MelyGalvez/Volting-MUSIC-Project/README.md

# Volting Music Project

Extension of Volting Music Project to a more immersive environnement in Tongji University.
