MelyGalvez/Volting-MUSIC-Project/Suit_Developement/Hardware/PCB/Central_Unit/V1/Images/PCB_Images/Central_Unit_PCB.pdf

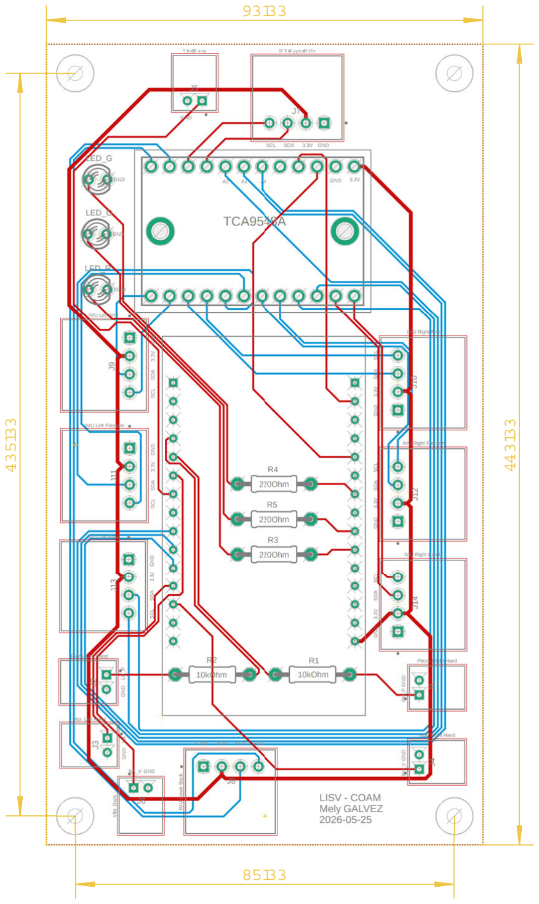
[picture p1: figure]
Vibr. Front; IMU U pper Back
