MelyGalvez/Volting-MUSIC-Project/Suit_Developement/Hardware/PCB/Central_Unit/V2/Images/PCB_Images/Central_Unit_V2_Bottom.png

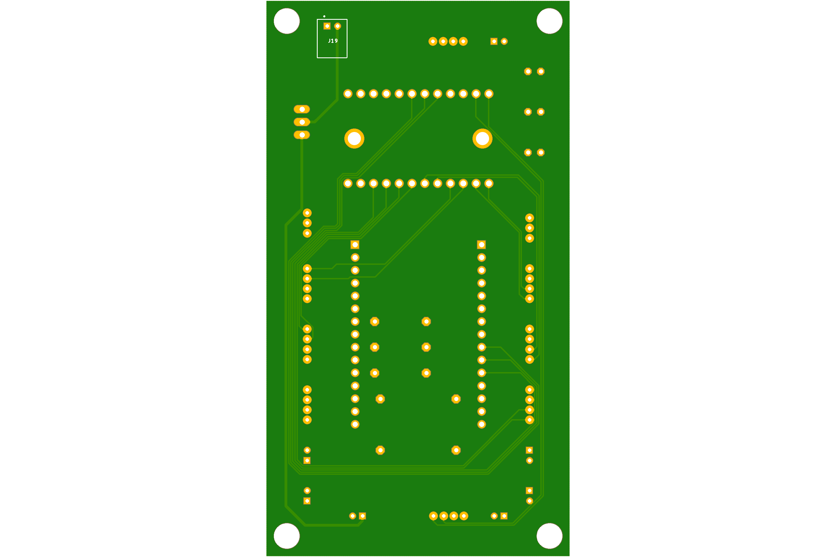
Suit_Developement/Hardware/PCB/Central_Unit/V2/Images/PCB_Images/Central_Unit_V2_Bottom.png
