MelyGalvez/Volting-MUSIC-Project/Suit_Developement/Hardware/PCB/IMU/Images/PCB_Images/IMU_PCB_Bottom.png

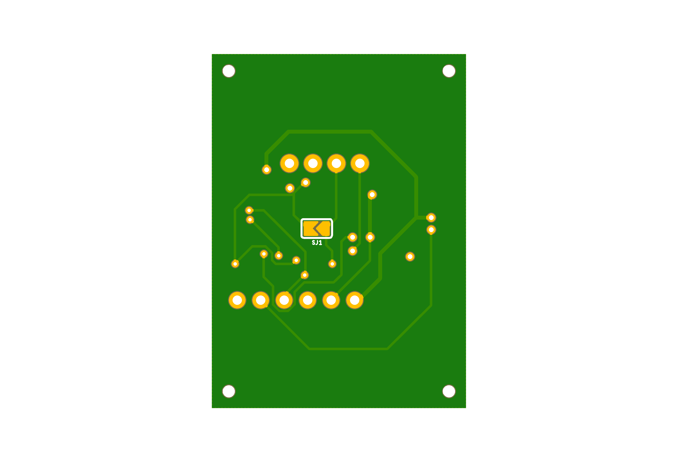
Suit_Developement/Hardware/PCB/IMU/Images/PCB_Images/IMU_PCB_Bottom.png
