MelyGalvez/Volting-MUSIC-Project/Suit_Developement/Hardware/PCB/IMU/Images/PCB_Images/IMU_PCB_Drills.png

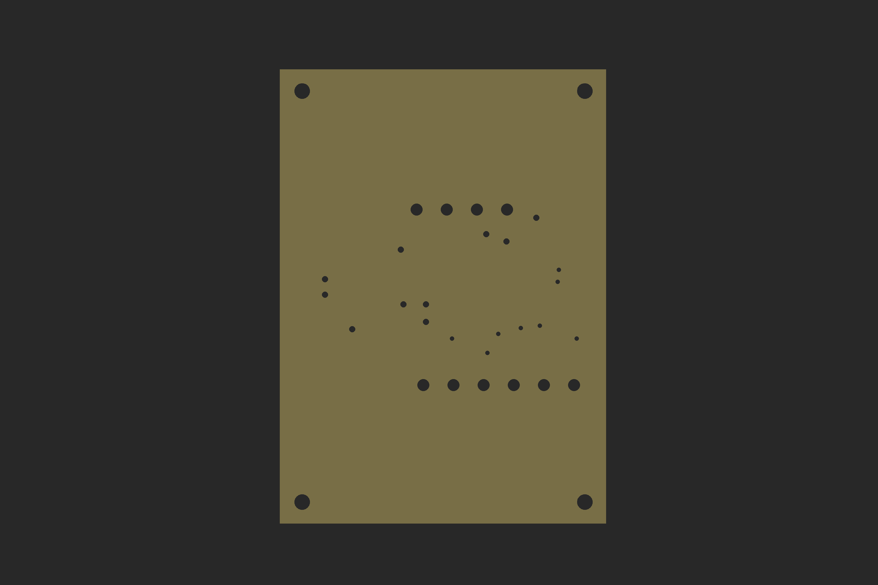
Suit_Developement/Hardware/PCB/IMU/Images/PCB_Images/IMU_PCB_Drills.png
