MelyGalvez/Volting-MUSIC-Project/Suit_Developement/Hardware/PCB/IMU_Breakout/Images/PCB_Images/IMU_PCB_Breakout_Bottom.png

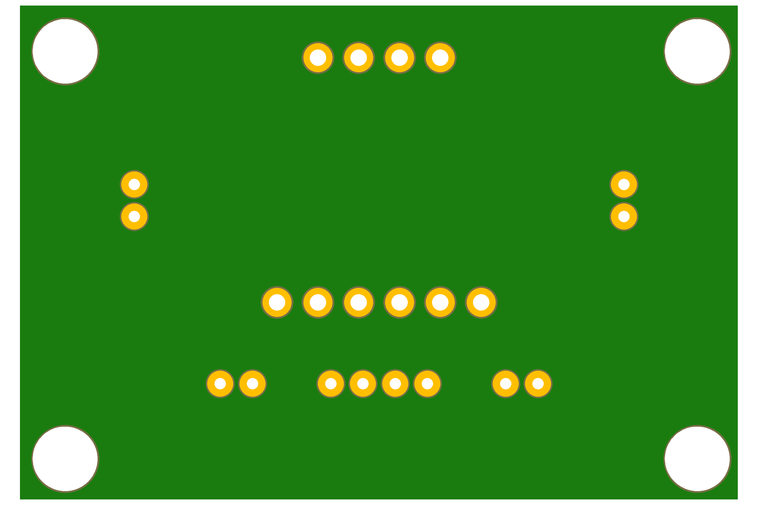
Suit_Developement/Hardware/PCB/IMU_Breakout/Images/PCB_Images/IMU_PCB_Breakout_Bottom.png
