MelyGalvez/Volting-MUSIC-Project/Suit_Developement/Software/Perceptual_Space/Interfaces/Visual/Images/Motion_Capture_3D.PNG

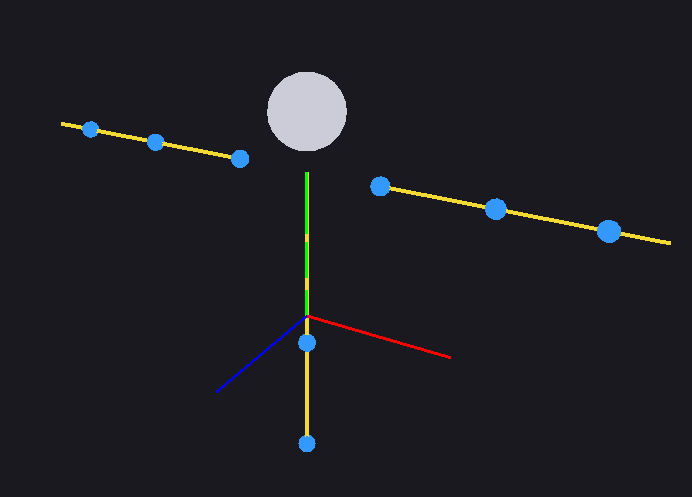
Suit_Developement/Software/Perceptual_Space/Interfaces/Visual/Images/Motion_Capture_3D.PNG
