MelyGalvez/Volting-MUSIC-Project/Suit_Developement/Software/Perceptual_Space/Interfaces/Visual/Images/Touch_Designer.PNG

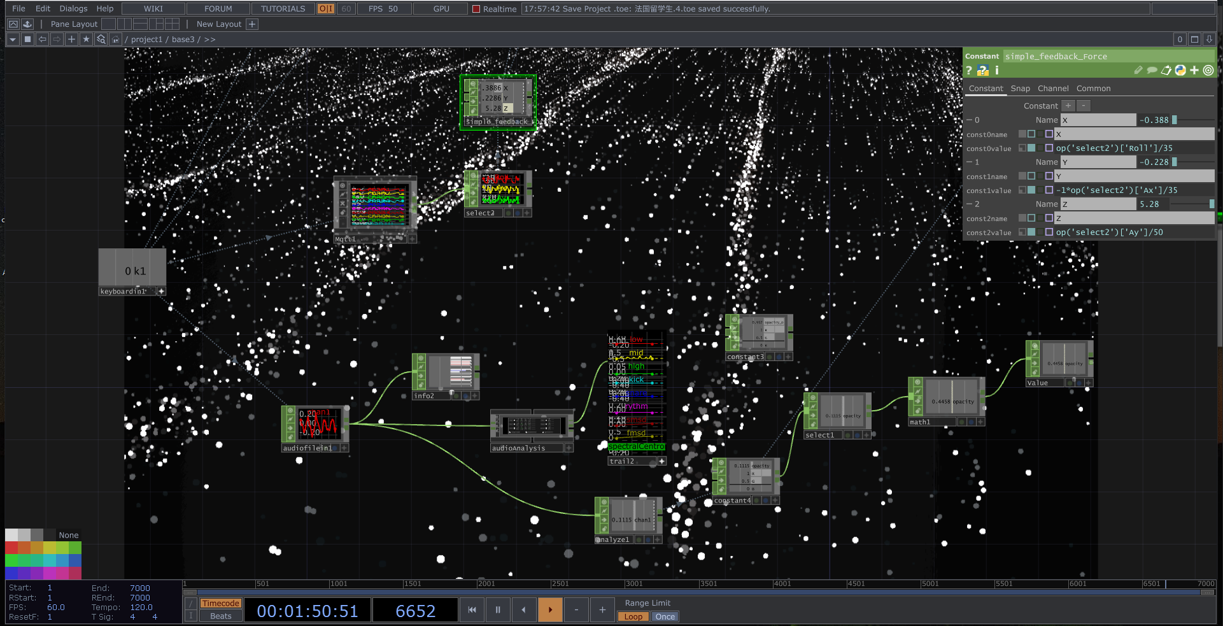
Suit_Developement/Software/Perceptual_Space/Interfaces/Visual/Images/Touch_Designer.PNG
