MelyGalvez/Volting-MUSIC-Project/Suit_Developement/Hardware/Case/Central_Unit_Case/Central_Unit_Case_V2.3mf

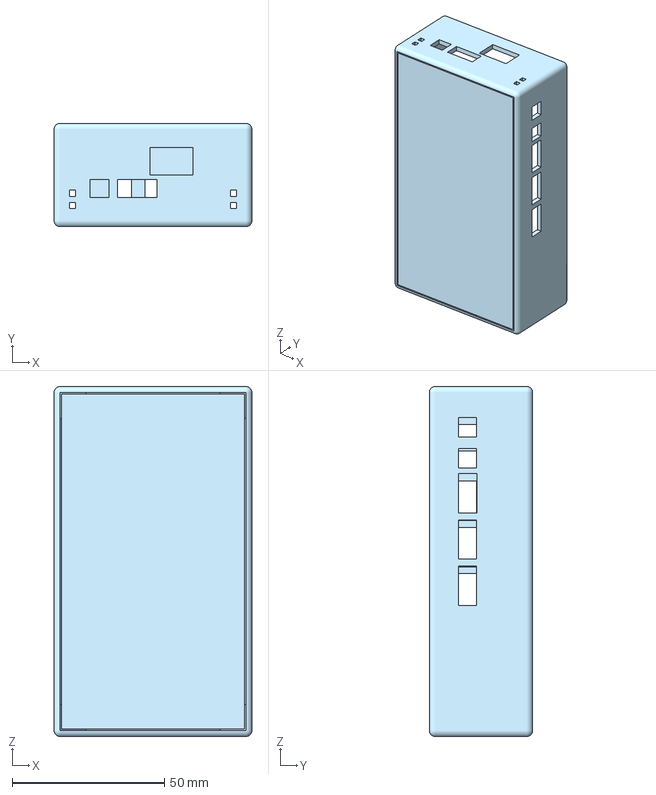
[picture p12: CAD file, 2026-07-07]
Suit_Developement/Hardware/Case/Central_Unit_Case/Central_Unit_Case_V2.3mf
65.0 x 34.0 x 115.0 mm
