MelyGalvez/Volting-MUSIC-Project/Suit_Developement/Hardware/Case/IMU_Breakout_Case/IMU_Breakout_Case.stl

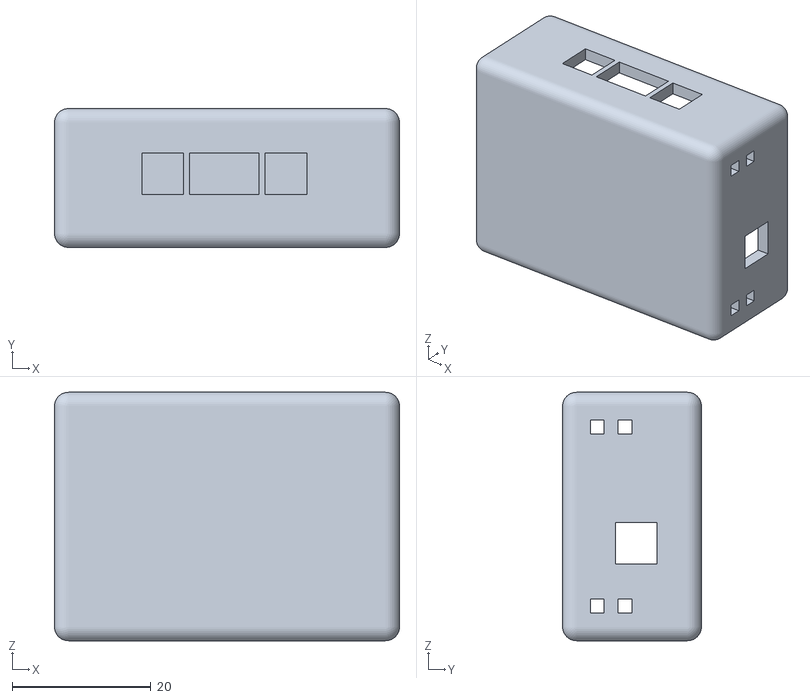
[picture p13: CAD file, 2026-05-29]
Suit_Developement/Hardware/Case/IMU_Breakout_Case/IMU_Breakout_Case.stl
49.7 x 20.0 x 35.8
