MelyGalvez/Volting-MUSIC-Project/Immersive_Env_Test/Measurememt codes/Volting_MUSIC_All_Data_Measurement/Measuremets results/Position_Measurement_20260420_160034.csv

time | ACC_x | ACC_y | ACC_z | GYRO_x | GYRO_y | GYRO_z | MAG_x | MAG_y | MAG_z | D1 | D2 | BTN1 | BTN2
1776672035.715073 | 12 | 10 | 253 | -791 | 31 | -13 | 162 | -126 | -431 | 3 | 0 | 0 | 0
1776672035.8428078 | 13 | 10 | 253 | -778 | 52 | -3 | 163 | -128 | -432 | 3 | 0 | 0 | 0
1776672035.9693692 | 12 | 12 | 254 | -753 | 35 | -5 | 165 | -128 | -432 | 3 | 0 | 0 | 0
1776672036.0951345 | 13 | 11 | 253 | -800 | 49 | -11 | 164 | -127 | -432 | 3 | 0 | 0 | 0
1776672036.222291 | 12 | 11 | 253 | -793 | 19 | -24 | 164 | -128 | -432 | 3 | 0 | 0 | 0
1776672036.34781 | 13 | 10 | 254 | -784 | 3 | -24 | 164 | -128 | -432 | 3 | 0 | 0 | 0
1776672036.4747362 | 12 | 12 | 253 | -779 | 53 | -22 | 164 | -128 | -433 | 3 | 0 | 0 | 0
1776672036.6024406 | 13 | 10 | 252 | -782 | 43 | -7 | 164 | -128 | -433 | 3 | 0 | 0 | 0
1776672036.7273338 | 13 | 10 | 254 | -790 | 36 | -7 | 163 | -127 | -432 | 3 | 0 | 0 | 0
1776672036.8556764 | 12 | 12 | 253 | -792 | 26 | -33 | 163 | -129 | -430 | 3 | 0 | 0 | 0
1776672036.9809878 | 12 | 11 | 255 | -807 | 33 | -15 | 164 | -128 | -432 | 3 | 0 | 0 | 0
1776672037.1074395 | 13 | 10 | 253 | -793 | 38 | -2 | 164 | -128 | -432 | 3 | 0 | 0 | 0
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
