MelyGalvez/Volting-MUSIC-Project/Immersive_Env_Test/Measurememt codes/Volting_MUSIC_All_Data_Measurement/Measuremets results/Position_Measurement_20260420_164400.csv

time | ACC_x | ACC_y | ACC_z | GYRO_x | GYRO_y | GYRO_z | MAG_x | MAG_y | MAG_z | D1 | D2 | BTN1 | BTN2
1776674642.1041398 | -7 | 259 | -3 | -588 | -650 | 524 | -425 | -378 | -42 | 3 | 0 | 0 | 0
1776674642.231054 | -4 | 265 | -10 | -1187 | -1287 | 904 | -424 | -375 | -31 | 5 | 0 | 0 | 0
1776674642.3591402 | -2 | 262 | -5 | -226 | -448 | 157 | -426 | -373 | -22 | 6 | 0 | 0 | 0
1776674642.4864442 | -12 | 257 | -6 | 631 | -1206 | -889 | -421 | -371 | -6 | 10 | 0 | 0 | 0
1776674642.6425881 | -14 | 274 | -17 | -755 | 492 | 53 | -412 | -374 | 7 | 0 | 0 | 0 | 0
1776674642.7886276 | -14 | 268 | -22 | -205 | -1375 | 486 | -411 | -371 | 19 | 0 | 0 | 0 | 0
1776674642.9445589 | -14 | 269 | -14 | -2376 | -3247 | -1757 | -402 | -368 | 40 | 0 | 0 | 0 | 0
1776674643.0921638 | -19 | 256 | -21 | -1032 | -5416 | -377 | -377 | -378 | 63 | 0 | 0 | 0 | 0
1776674643.2195287 | -17 | 261 | -7 | -2073 | 2171 | -1840 | -355 | -374 | 98 | 11 | 0 | 0 | 0
1776674643.3466606 | -13 | 254 | -6 | -1380 | -2435 | -1942 | -340 | -382 | 103 | 3 | 0 | 0 | 0
1776674643.4735425 | -10 | 256 | -12 | 486 | -2093 | -356 | -312 | -395 | 115 | 2 | 0 | 0 | 0
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
