MelyGalvez/Volting-MUSIC-Project/Initial_Prototype/V1/PCB/Measurement_Device_PCB/silk.pdf

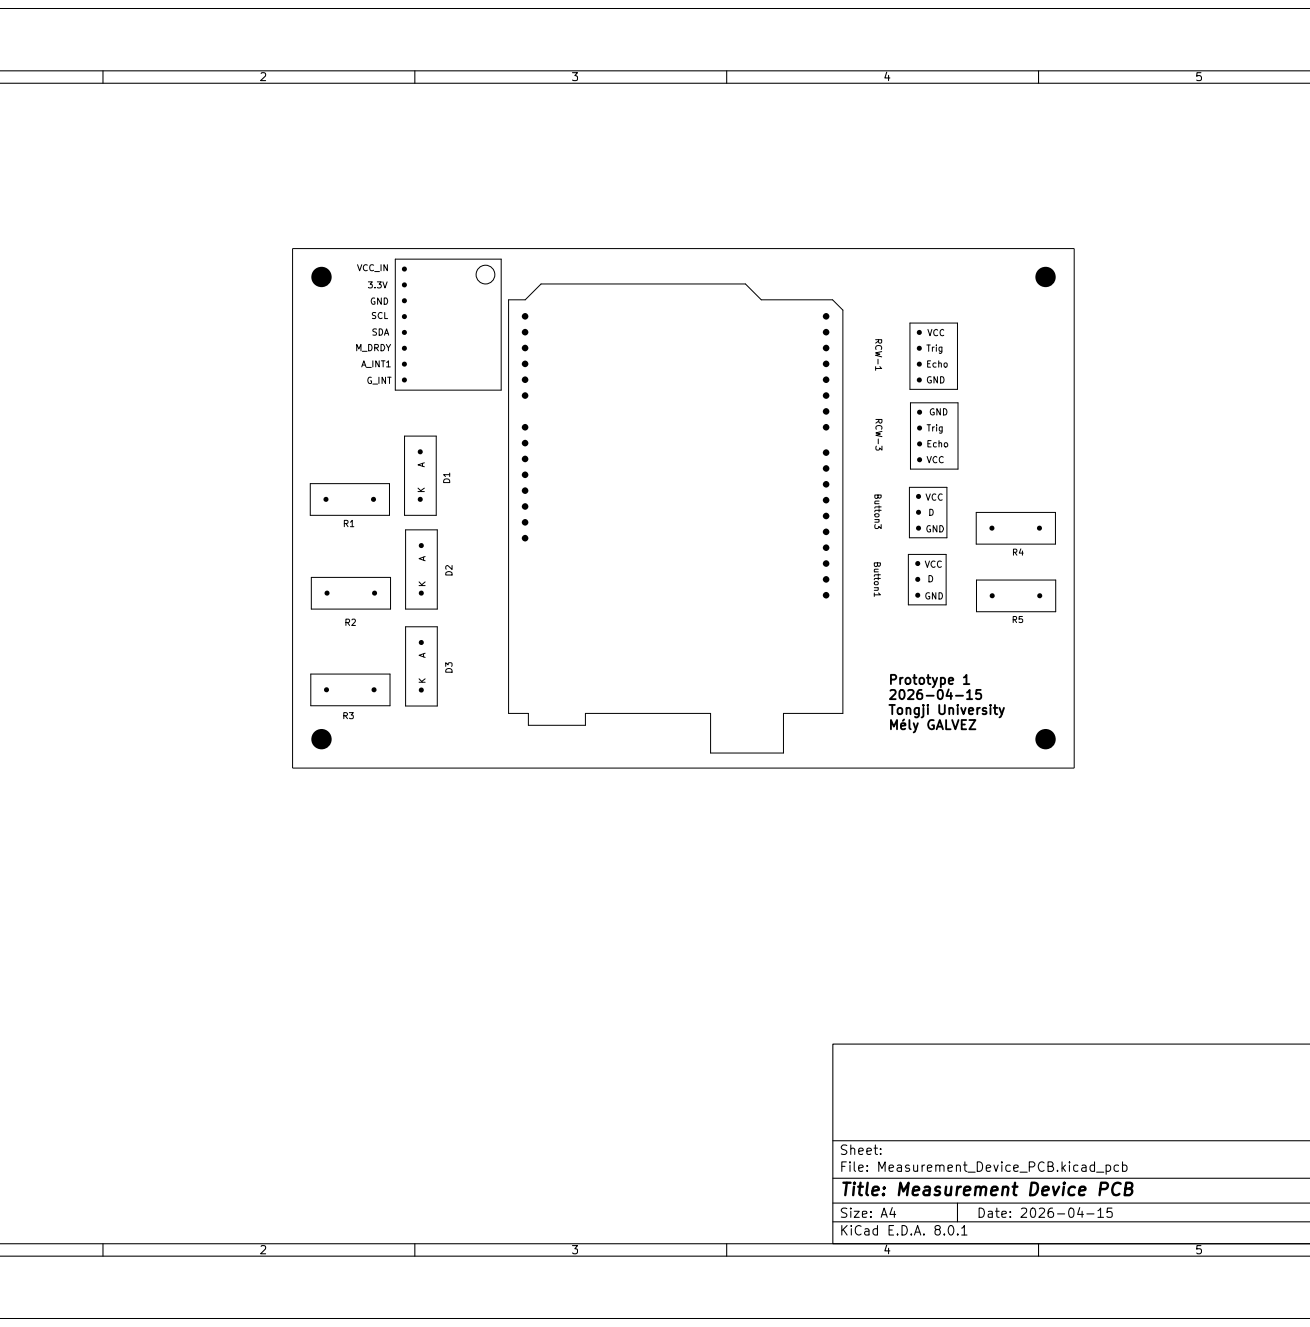
[picture p14: page 1]
