MelyGalvez/Volting-MUSIC-Project/Suit_Developement/Hardware/PCB/IMU_Breakout/Images/PCB_Images/IMU_PCB_Breakout.pdf

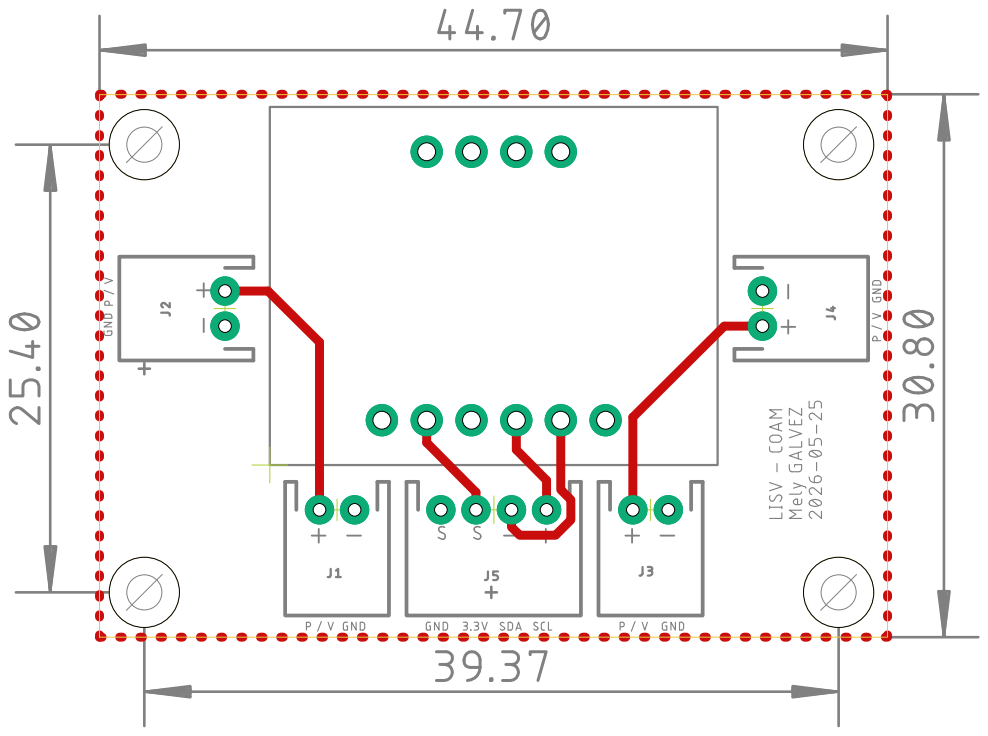
[picture p15: page 1]
