MelyGalvez/Volting-MUSIC-Project/Suit_Developement/Hardware/PCB/IMU/Images/PCB_Images/IMU_PCB.pdf

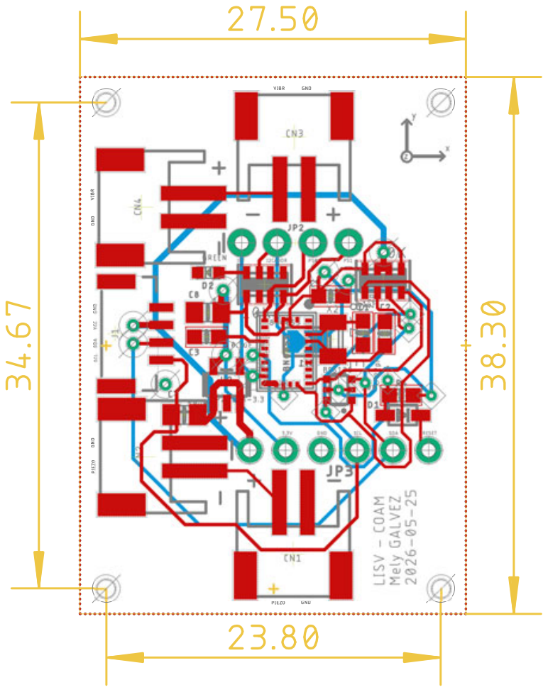
[picture p16: page 1]
