MelyGalvez/Volting-MUSIC-Project/Initial_Prototype/V1/PCB/Measurement_Device_PCB_Kicad/Measurement_Device_PCB.kicad_pcb

## KiCad design Initial_Prototype/V1/PCB/Measurement_Device_PCB_Kicad/Measurement_Device_PCB.kicad_pcb (2026-04-15)

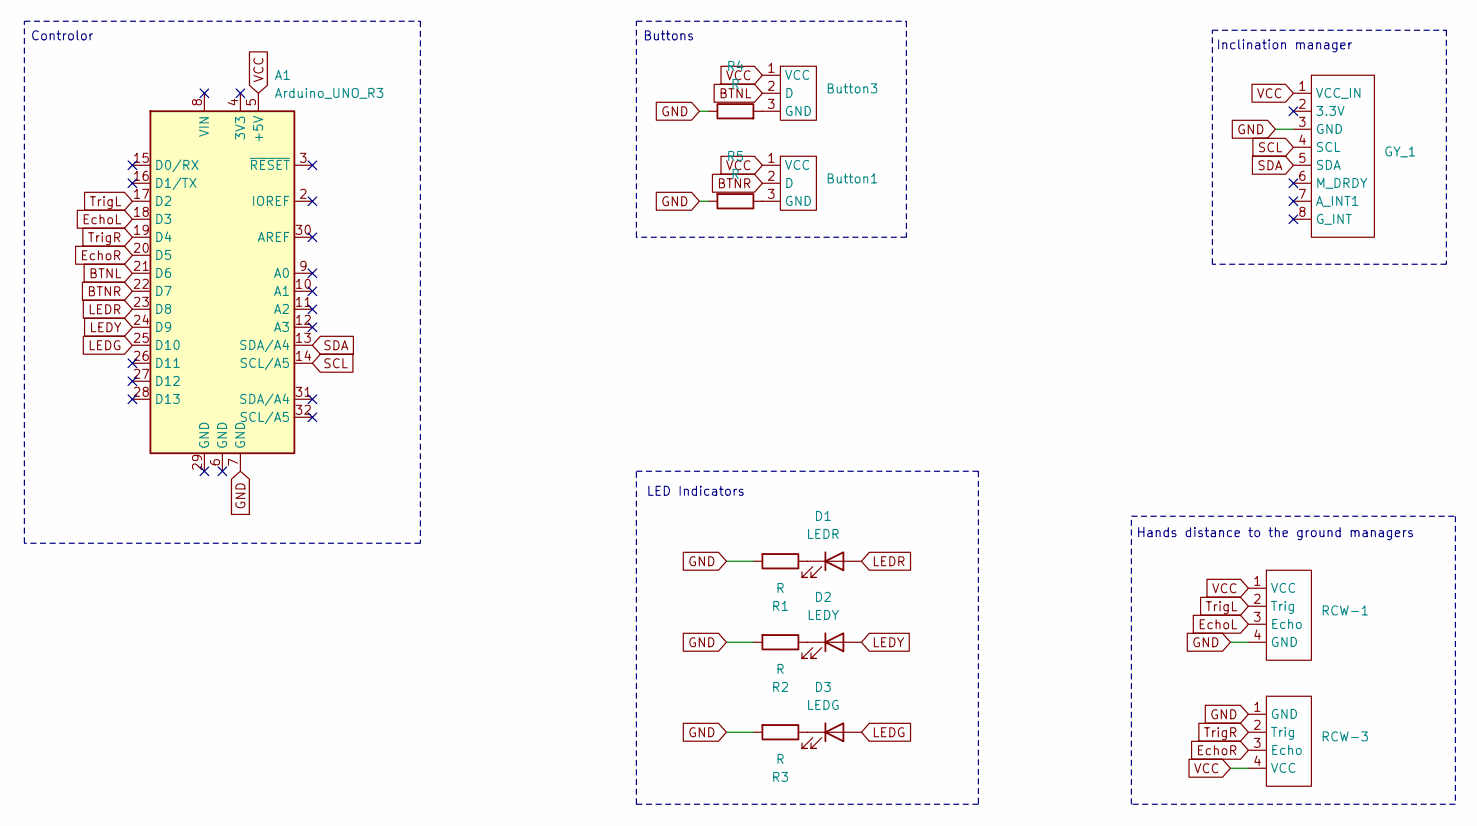
[picture p18: schematic Measurement_Device_PCB.kicad_sch, Mesurement device of chest inclination and hands positions]

Parts:
A1: Arduino_UNO_R3
Button1, Button3: Button
D1: LEDR; LED
D2: LEDY; LED
D3: LEDG; LED
GY_1: GY_85
R1, R2, R3, R4, R5: R
RCW-1, RCW-3: RCW-0001

Connections:
BTNL: A1.21 (D6), Button3.2 (D)
BTNR: A1.22 (D7), Button1.2 (D)
EchoL: A1.18 (D3), RCW-1.3 (Echo)
EchoR: A1.20 (D5), RCW-3.3 (Echo)
GND: A1.7 (GND), GY_1.3 (GND), R1.2, R2.2, R3.2, R4.1, R5.2, RCW-1.4 (GND), RCW-3.1 (GND)
LEDG: A1.25 (D10), D3.2 (A)
LEDR: A1.23 (D8), D1.2 (A)
LEDY: A1.24 (D9), D2.2 (A)
unnamed: Button1.3 (GND), R5.1
unnamed: Button3.3 (GND), R4.2
unnamed: D1.1 (K), R1.1
unnamed: D2.1 (K), R2.1
unnamed: D3.1 (K), R3.1
SCL: A1.14 (SCL/A5), GY_1.4 (SCL)
SDA: A1.13 (SDA/A4), GY_1.5 (SDA)
TrigL: A1.17 (D2), RCW-1.2 (Trig)
TrigR: A1.19 (D4), RCW-3.2 (Trig)
VCC: A1.5 (+5V), Button1.1 (VCC), Button3.1 (VCC), GY_1.1 (VCC_IN), RCW-1.1 (VCC), RCW-3.4 (VCC)

Notes on the sheet:
Controlor
Buttons
LED Indicators
Hands distance to the ground managers
Inclination manager

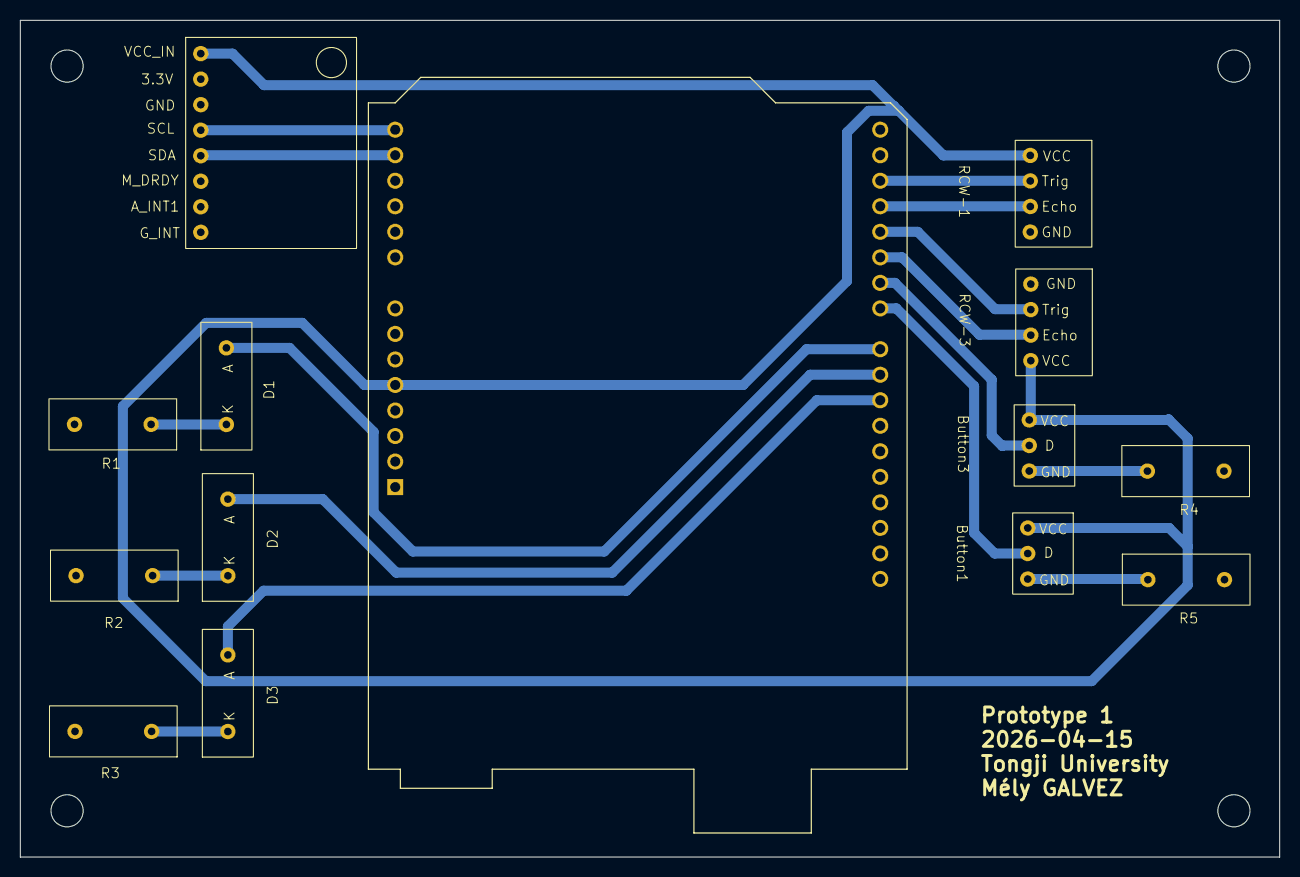
[picture p19: board Measurement_Device_PCB.kicad_pcb from above]

Board: 2 copper layers, 125.3 x 83.2 mm, 14 parts (0 on the bottom side), 18 nets.
