MelyGalvez/Volting-MUSIC-Project/Suit_Developement/Hardware/PCB/Central_Unit/V1/Project/Central_Unit_PCB.brd

## EAGLE design Suit_Developement/Hardware/PCB/Central_Unit/V1/Project/Central_Unit_PCB.brd (2026-05-28, an earlier design)

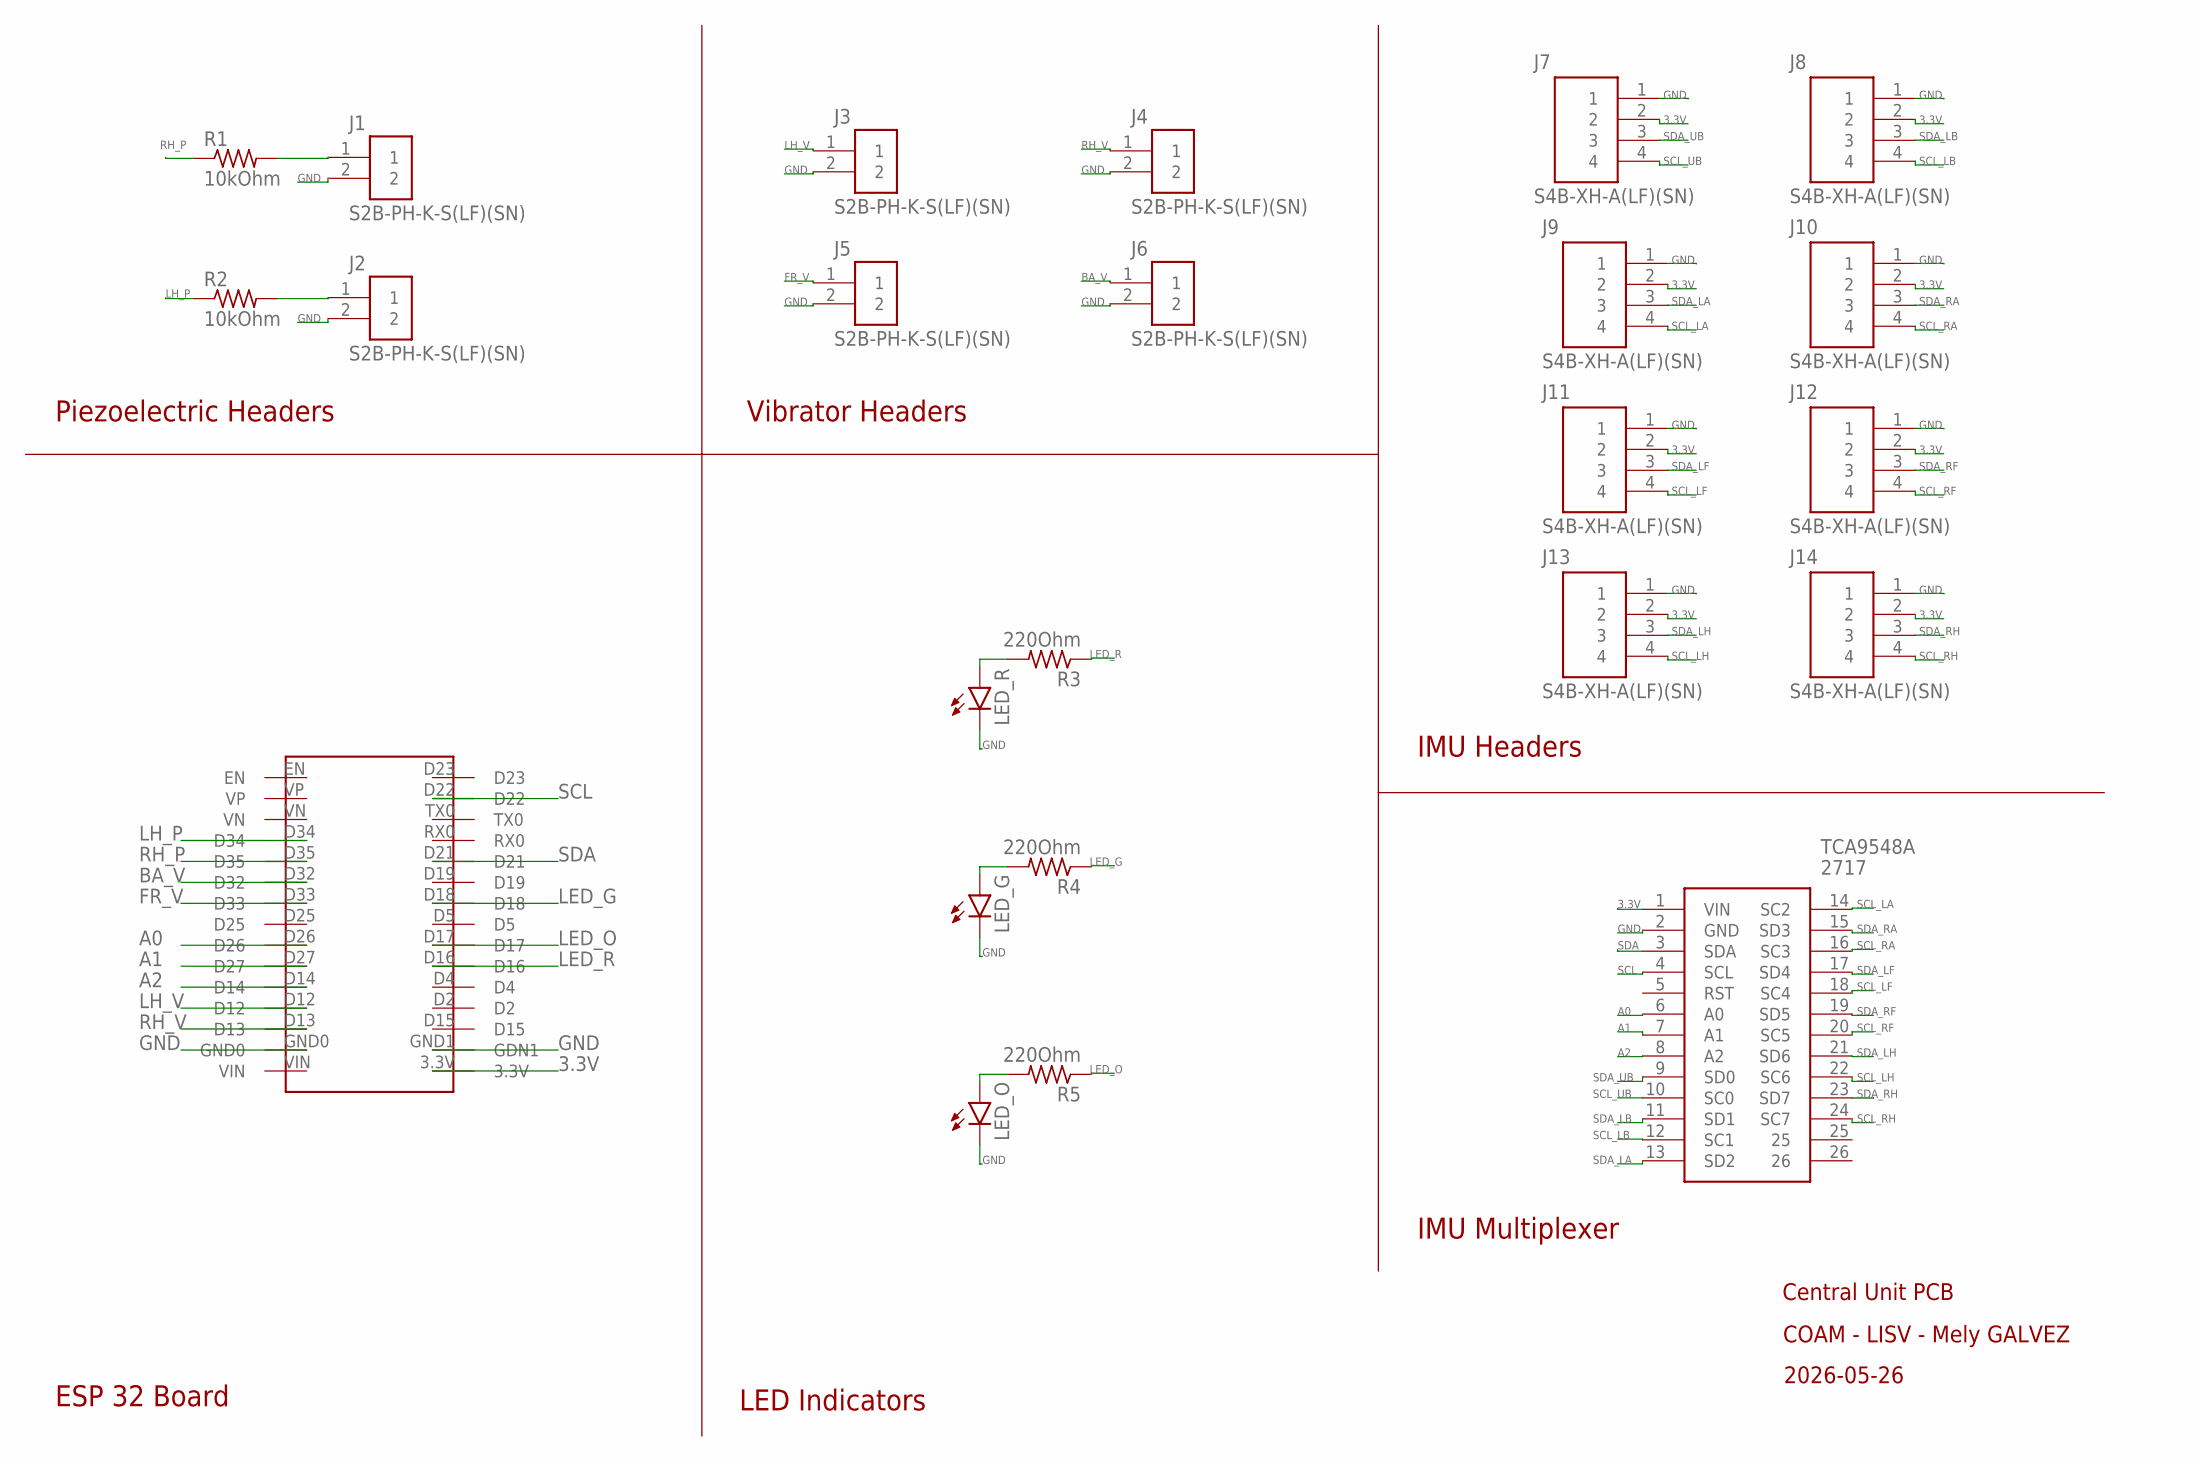
[picture p20: schematic Central_Unit_PCB.sch]

Parts:
J1, J2, J3, J4, J5, J6: S2B-PH-K-S(LF)(SN)
J7, J8, J9, J10, J11, J12, J13, J14: S4B-XH-A(LF)(SN); HDR-04/RA
LED_G: LED3MM
LED_O: LED3MM
LED_R: LED3MM
R1, R2: 10kOhm; 0207/10
R3, R4, R5: 220Ohm; 0207/10
TCA9548A: 2717
U$1: ESP32_WROUM32

Connections:
3.3V: J7.2, J8.2, J9.2, J10.2, J11.2, J12.2, J13.2, J14.2, TCA9548A.1 (VIN), U$1.3.3V
A0: TCA9548A.6 (A0), U$1.D26
A1: TCA9548A.7 (A1), U$1.D27
A2: TCA9548A.8 (A2), U$1.D14
BA_V: J6.1, U$1.D32
FR_V: J5.1, U$1.D33
GND: J1.2, J2.2, J3.2, J4.2, J5.2, J6.2, J7.1, J8.1, J9.1, J10.1, J11.1, J12.1, J13.1, J14.1, LED_G.K (C), LED_O.K (C), LED_R.K (C), TCA9548A.2 (GND), U$1.GND0, U$1.GND1 (GDN1)
LED_G: R4.1, U$1.D18
LED_O: R5.1, U$1.D17
LED_R: R3.1, U$1.D16
LH_P: R2.1, U$1.D34
LH_V: J3.1, U$1.D12
unnamed: J1.1, R1.2
unnamed: J2.1, R2.2
unnamed: LED_R.A, R3.2
unnamed: LED_G.A, R4.2
unnamed: LED_O.A, R5.2
RH_P: R1.1, U$1.D35
RH_V: J4.1, U$1.D13
SCL: TCA9548A.4 (SCL), U$1.D22
SCL_LA: J9.4, TCA9548A.14 (SC2)
SCL_LB: J8.4, TCA9548A.12 (SC1)
SCL_LF: J11.4, TCA9548A.18 (SC4)
SCL_LH: J13.4, TCA9548A.22 (SC6)
SCL_RA: J10.4, TCA9548A.16 (SC3)
SCL_RF: J12.4, TCA9548A.20 (SC5)
SCL_RH: J14.4, TCA9548A.24 (SC7)
SCL_UB: J7.4, TCA9548A.10 (SC0)
SDA: TCA9548A.3 (SDA), U$1.D21
SDA_LA: J9.3, TCA9548A.13 (SD2)
SDA_LB: J8.3, TCA9548A.11 (SD1)
SDA_LF: J11.3, TCA9548A.17 (SD4)
SDA_LH: J13.3, TCA9548A.21 (SD6)
SDA_RA: J10.3, TCA9548A.15 (SD3)
SDA_RF: J12.3, TCA9548A.19 (SD5)
SDA_RH: J14.3, TCA9548A.23 (SD7)
SDA_UB: J7.3, TCA9548A.9 (SD0)

Notes on the sheet:
Central Unit PCB
COAM - LISV - Mely GALVEZ
2026-05-26
LED Indicators
ESP 32 Board
Piezoelectric Headers
Vibrator Headers
IMU Headers
IMU Multiplexer

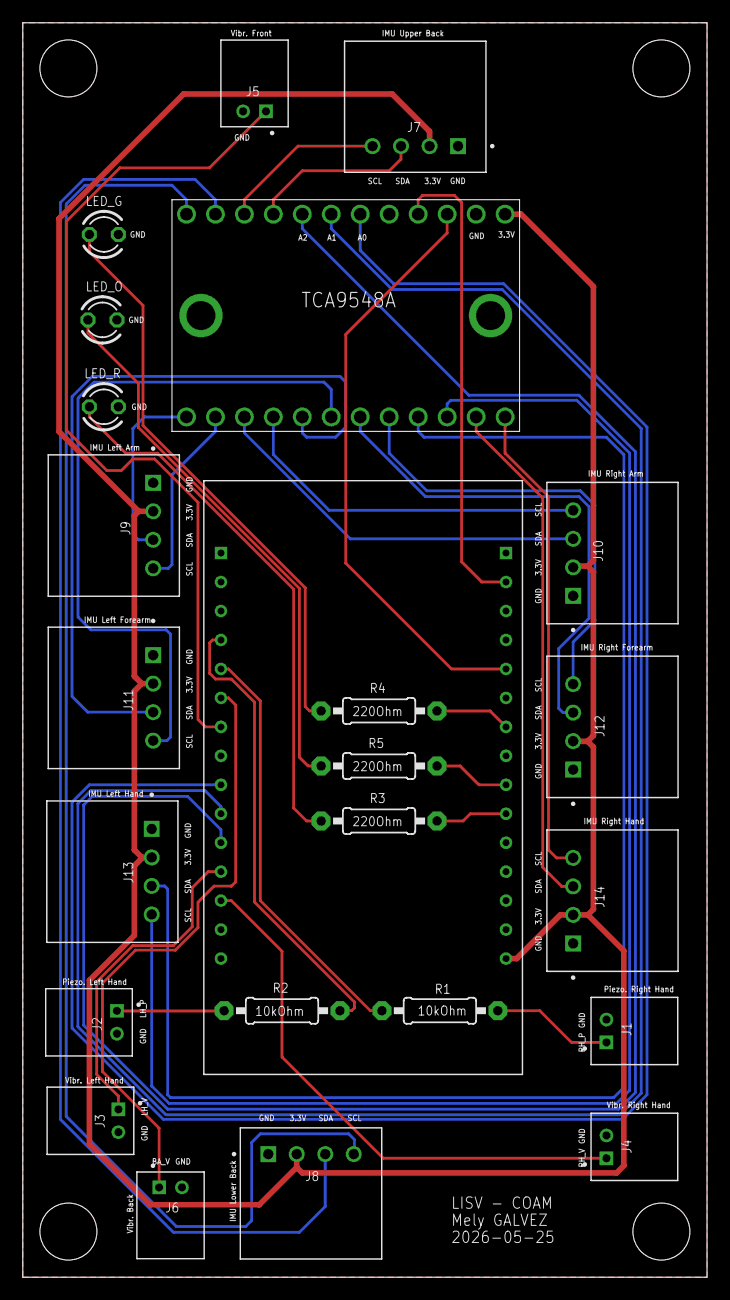
[picture p21: board Central_Unit_PCB.brd from above]

Board: 2 copper layers, 60.0 x 110.0 mm, 24 parts (0 on the bottom side), 37 nets.
