MelyGalvez/Volting-MUSIC-Project/Suit_Developement/Hardware/PCB/IMU/Project/IMU_PCB.brd

## EAGLE design Suit_Developement/Hardware/PCB/IMU/Project/IMU_PCB.brd (2026-05-28)

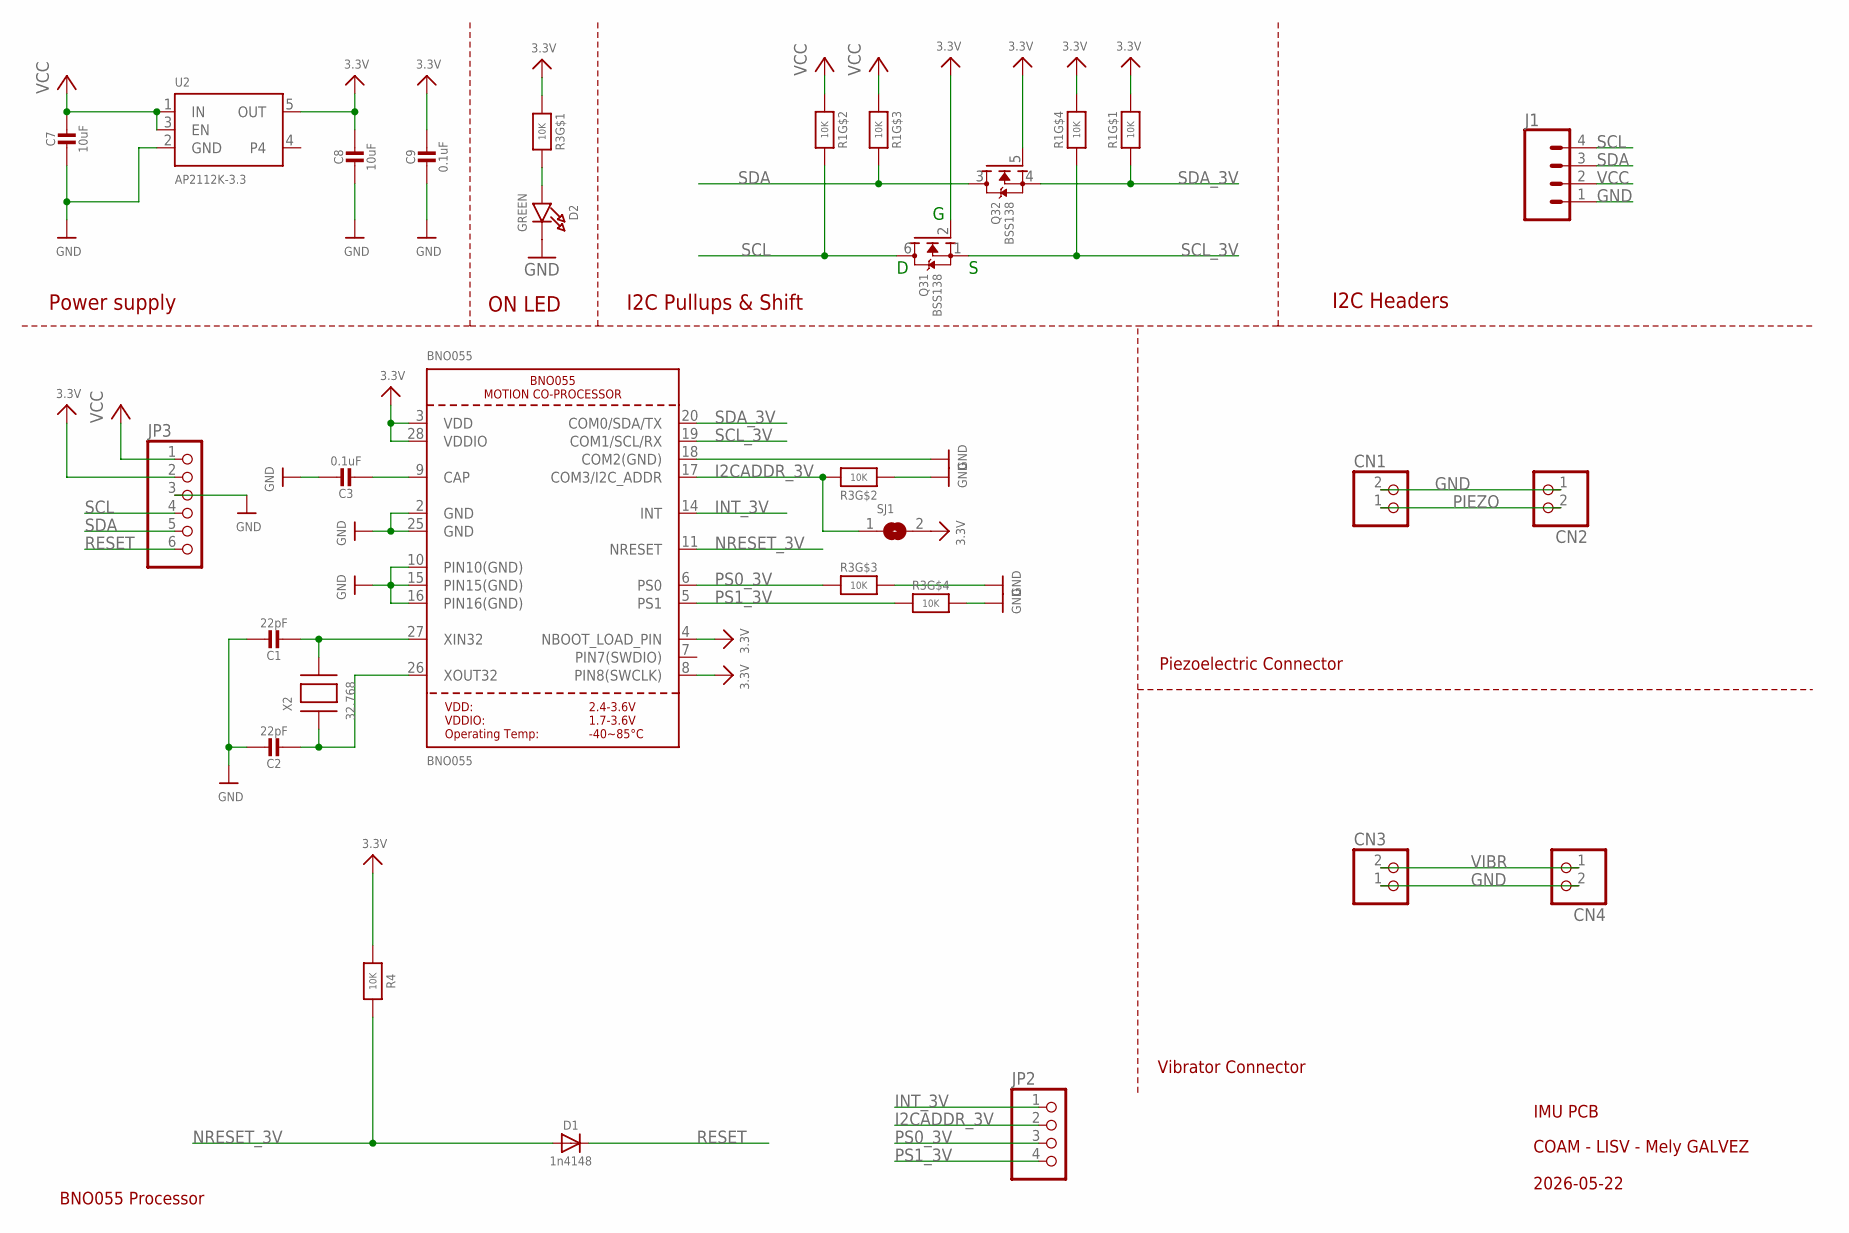
[picture p22: schematic IMU_PCB.sch]

Parts:
BNO055: BNO055
C1, C2: 22pF; 0603-NO
C3, C9: 0.1uF; 0603-NO
C7, C8: 10uF; 0805-NO
CN1, CN2, CN3, CN4: JST_2PIN-SMT-RA; JST-PH-2-SMT-RA
D1: 1n4148; SOD-323
D2: GREEN; CHIPLED_0603_NOOUTLINE
J1: CONN_04JST-SMD-LOCKING; JST-4-SMD-1.25MM-LOCKING
JP2: HEADER-1X476MIL; 1X04_ROUND_76
JP3: HEADER-1X670MIL; 1X06_ROUND_70
Q3: BSS138; SOT363
R1, R3: 10K; RESPACK_4X0603
R4: 10K; 0603-NO
SJ1: SOLDERJUMPER; SOLDERJUMPER_ARROW_NOPASTE
U2: AP2112K-3.3; SOT23-5
X2: 32.768; XTAL3215

Connections:
3.3V: BNO055.3 (VDD), BNO055.4 (NBOOT_LOAD_PIN), BNO055.8 (PIN8(SWCLK)), BNO055.28 (VDDIO), C8.1, C9.1, JP3.2, Q3.2 (G), Q3.5 (G), R1.1, R1.4 (1), R3.1, R4.1, SJ1.2, U2.5 (OUT)
GND: BNO055.2 (GND), BNO055.10 (PIN10(GND)), BNO055.15 (PIN15(GND)), BNO055.16 (PIN16(GND)), BNO055.18 (COM2(GND)), BNO055.25 (GND), C1.1, C2.1, C3.1, C7.2, C8.2, C9.2, CN1.2 (1), CN2.1 (2), CN3.1 (2), CN4.2 (1), D2.C, J1.1, JP3.3, R3.2 (1), R3.5 (2), R3.6 (2), U2.2 (GND)
I2CADDR_3V: BNO055.17 (COM3/I2C_ADDR), JP2.2, R3.7 (2), SJ1.1
INT_3V: BNO055.14 (INT), JP2.1
unnamed: BNO055.27 (XIN32), C1.2, X2.P$2
unnamed: BNO055.26 (XOUT32), C2.2, X2.P$1
unnamed: BNO055.9 (CAP), C3.2
unnamed: D2.A, R3.8 (2)
NRESET_3V: BNO055.11 (NRESET), D1.A, R4.2
PIEZO: CN1.1 (2), CN2.2 (1)
PS0_3V: BNO055.6 (PS0), JP2.3, R3.3 (1)
PS1_3V: BNO055.5 (PS1), JP2.4, R3.4 (1)
RESET: D1.C, JP3.6
SCL: J1.4, JP3.4, Q3.6 (D), R1.7 (2)
SCL_3V: BNO055.19 (COM1/SCL/RX), Q3.1 (S), R1.5 (2)
SDA: J1.3, JP3.5, Q3.3 (D), R1.6 (2)
SDA_3V: BNO055.20 (COM0/SDA/TX), Q3.4 (S), R1.8 (2)
VCC: C7.1, J1.2, JP3.1, R1.2 (1), R1.3 (1), U2.1 (IN), U2.3 (EN)
VIBR: CN3.2 (1), CN4.1 (2)

Notes on the sheet:
IMU PCB
COAM - LISV - Mely GALVEZ
2026-05-22
I2C Pullups & Shift
I2C Headers
ON LED
Power supply
BNO055 Processor
Piezoelectric Connector
Vibrator Connector

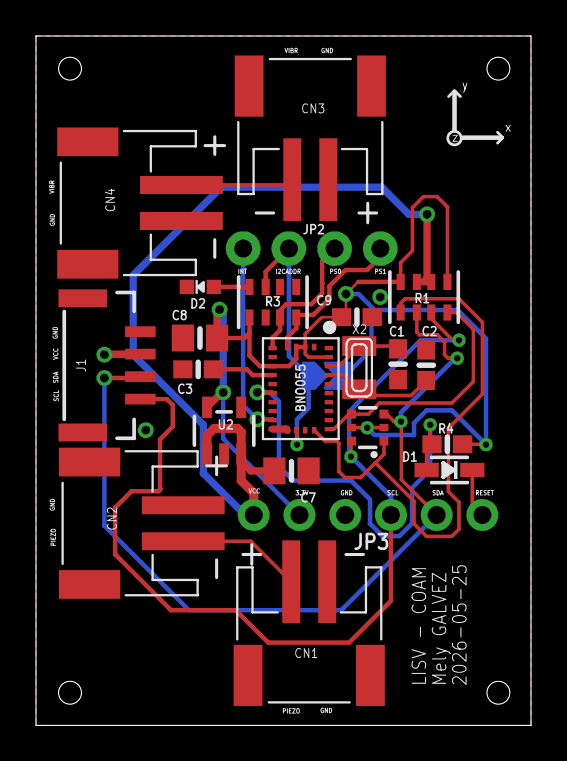
[picture p23: board IMU_PCB.brd from above]

Board: 2 copper layers, 27.5 x 38.3 mm, 23 parts (1 on the bottom side), 19 nets.
