MelyGalvez/Volting-MUSIC-Project/Suit_Developement/Software/Get_Data/V5/Arduino_Suit_ESP32_Get_Data_V4/gpio.cpp

#include "gpio.h"
#include "config.h"


// ================================================
// GPIO.cpp
// ================================================


// ---------------- Initialization ----------------


void initializeGPIO()
{

    // ------------------- LEDs -------------------

    pinMode(LED_RED_PIN, OUTPUT);
    pinMode(LED_YELLOW_PIN, OUTPUT);
    pinMode(LED_GREEN_PIN, OUTPUT);

    setRedLED(false);
    setYellowLED(false);
    setGreenLED(false);

    // ------------------ Piezos ------------------

    pinMode(PIEZO_LEFT_PIN, INPUT);
    pinMode(PIEZO_RIGHT_PIN, INPUT);

    analogReadResolution(12);
    analogSetPinAttenuation(PIEZO_LEFT_PIN, ADC_11db);
    analogSetPinAttenuation(PIEZO_RIGHT_PIN, ADC_11db);
}


// -------------------- LEDs ---------------------


void setRedLED(bool state)
{
    digitalWrite(LED_RED_PIN, state);
}

void setYellowLED(bool state)
{
    digitalWrite(LED_YELLOW_PIN, state);
}

void setGreenLED(bool state)
{
    digitalWrite(LED_GREEN_PIN, state);
}


// ------------------- Piezos --------------------


uint16_t readLeftPiezo()
{
    return (uint16_t)analogRead(PIEZO_LEFT_PIN);
}

uint16_t readRightPiezo()
{
    return (uint16_t)analogRead(PIEZO_RIGHT_PIN);
}
