MelyGalvez/Volting-MUSIC-Project/Suit_Developement/Software/Get_Data/V5/Arduino_Suit_ESP32_Get_Data_V4/acquisition.h

#pragma once


// ================================================
// ACQUISITION.h
// ================================================


/**
 * @brief Start the continuous IMU scanning task.
 *
 * Runs the boot calibration (when enabled), keeps the
 * shared snapshot fresh and maintains the system state.
 */
void startAcquisitionTask();
