MelyGalvez/Volting-MUSIC-Project/Suit_Developement/Software/Get_Data/V5/Arduino_Suit_ESP32_Get_Data_V4/mux.h

#pragma once

#include <Arduino.h>


// ================================================
// MUX.h
// ================================================


/**
 * @brief Configure the I2C peripheral (pins, clock, timeout).
 */
void initializeI2C();


/**
 * @brief Set the bus clock (no-op when already at that value).
 *
 * The bus configuration belongs to this module, so the cached
 * value is reset by initializeI2C() and a bus recovery cannot
 * leave callers believing a stale clock is still applied.
 */
void setI2CClock(uint32_t hz);


/**
 * @brief Select one channel of the TCA9548A.
 *
 * Triggers an automatic bus recovery after repeated
 * addressing failures.
 *
 * @return true when the mux acknowledged the selection.
 */
bool selectMuxChannel(uint8_t channel);


/**
 * @brief Force a 9-clock I2C bus recovery and re-init.
 */
void recoverI2CBus();
