MelyGalvez/Volting-MUSIC-Project/Suit_Developement/Software/Get_Data/V5/Arduino_Suit_ESP32_Get_Data_V4/piezo.h

#pragma once


// ================================================
// PIEZO.h
// ================================================


/**
 * @brief Start the 1 kHz piezo sampling / hit detection task.
 */
void startPiezoTask();
