MelyGalvez/Volting-MUSIC-Project/Suit_Developement/Software/Get_Data/V5/Arduino_Suit_ESP32_Get_Data_V4/server.h

#pragma once


// ================================================
// SERVER.h
// ================================================


/**
 * @brief Initialize routes and start the HTTP server.
 */
void initializeServer();


/**
 * @brief Service pending HTTP clients (call from loop).
 */
void serverHandleClient();
