MelyGalvez/Volting-MUSIC-Project/Suit_Developement/Software/Get_Data/V5/Arduino_Suit_ESP32_Get_Data_V4/snapshot.h

#pragma once

#include "types.h"


// ================================================
// SNAPSHOT.h
// ================================================


/**
 * @brief Create the mutex. Call once before any task starts.
 */
void initializeSnapshot();


/**
 * @brief Publish a complete IMU scan (bumps seq + timestamp).
 */
void snapshotPublishImu(const ImuFrame frames[NUM_IMUS]);


/**
 * @brief Update the piezo section of the snapshot.
 */
void snapshotUpdatePiezo(
    const PiezoChannelState& left,
    const PiezoChannelState& right
);


/**
 * @brief Copy the latest self-consistent snapshot.
 */
void snapshotGet(Snapshot& out);
