MelyGalvez/Volting-MUSIC-Project/Suit_Developement/Software/Get_Data/V5/Arduino_Suit_ESP32_Get_Data_V4/status.h

#pragma once

#include "types.h"


// ================================================
// STATUS.h
// ================================================


void initializeStatus();


void setSystemState(SystemState state);


SystemState getSystemState();


/**
 * @brief Wire-protocol name of a system state.
 */
const char* systemStateName(SystemState state);


/**
 * @brief Update LEDs immediately.
 */
void refreshStatus();


/**
 * @brief Drive the calibration blink pattern (call from loop).
 */
void updateStatus();
