MelyGalvez/Volting-MUSIC-Project/Suit_Developement/Software/Get_Data/V5/Arduino_Suit_ESP32_Get_Data_V4/wifi_manager.cpp

#include <WiFi.h>

#include "wifi_manager.h"
#include "config.h"
#include "status.h"


// ================================================
// WIFI_MANAGER.cpp
// ================================================


// -------------- Initialisation ------------------


bool initializeWiFi()
{
    Serial.println();
    Serial.println("===============================");
    Serial.println("Initializing WiFi");
    Serial.println("===============================");

    // --------------- Access point ---------------

    WiFi.mode(WIFI_AP);

    bool success = WiFi.softAP(
        WIFI_SSID,
        WIFI_PASSWORD,
        WIFI_CHANNEL,
        false,
        WIFI_MAX_CLIENTS
    );

    if(!success)
    {
        Serial.println("Failed to create Access Point.");

        setSystemState(SYSTEM_ERROR);

        return false;
    }

    // ---------------- Information ---------------

    Serial.print("SSID : ");
    Serial.println(WIFI_SSID);

    Serial.print("IP Address : ");
    Serial.println(WiFi.softAPIP());

    Serial.println("WiFi ready.");

    return true;
}
