MelyGalvez/Volting-MUSIC-Project/Suit_Developement/Software/Get_Data/V5/Arduino_Suit_ESP32_Get_Data_V4/wifi_manager.h

#pragma once


// ================================================
// WIFI_MANAGER.h
// ================================================


/**
 * @brief Initialize the ESP32 as a WiFi Access Point.
 *
 * @return true when the access point started.
 */
bool initializeWiFi();
