MelyGalvez/Volting-MUSIC-Project/(commit log)

2026-04-13 Prototype's code uploading
    [Volting_MUSIC_EAGLE_Prototype_V1_2_Board.brd, Volting_MUSIC_EAGLE_Prototype_V1_2_Schematic.sch, Volting_MUSIC_Onshape_Prototype_V1_2_3D.stl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]
2026-04-13 Rename stl file
    [Volting_MUSIC_Onshape_Prototype_V1_3D.stl]
2026-04-15 New PCB
    [Measurement_Device_PCB-B_Cu.gbr, Measurement_Device_PCB-B_Mask.gbr, Measurement_Device_PCB-B_Paste.gbr, Measurement_Device_PCB-B_Silkscreen.gbr, Measurement_Device_PCB-Edge_Cuts.gbr, Measurement_Device_PCB-F_Cu.gbr, Measurement_Device_PCB-F_Mask.gbr, Measurement_Device_PCB-F_Paste.gbr]
2026-04-15 PCB Update
    [Measurement_Device_PCB-B_Cu.gbr, Measurement_Device_PCB-B_Mask.gbr, Measurement_Device_PCB-B_Paste.gbr, Measurement_Device_PCB-B_Silkscreen.gbr, Measurement_Device_PCB-Edge_Cuts.gbr, Measurement_Device_PCB-F_Cu.gbr, Measurement_Device_PCB-F_Mask.gbr, Measurement_Device_PCB-F_Paste.gbr]
2026-04-21 Measurements codes
    [donnees_volting_20260420_160034.csv, donnees_volting_20260420_164400.csv]
2026-04-23 Updates of P1 Arduino code
2026-04-23 Updates and modifications
    [Volting_MUSIC_Onshape_Prototype_V1_3D.stl, donnees_volting_20260420_160034.csv, donnees_volting_20260420_164400.csv]
2026-04-23 Measurement codes updates
    [Position_Measurement_20260423_131129.csv, donnees_volting_20260423_130955.csv]
2026-05-21 Suit Dev
    [Adafruit BNO055 STEMMA QT.brd, Adafruit BNO055 STEMMA QT.sch, Adafruit BNO055.brd, Adafruit BNO055.sch, Position_Measurement_20260420_160034.csv, Position_Measurement_20260420_164400.csv, Position_Measurement_20260423_130955.csv, Position_Measurement_20260423_131129.csv]
2026-05-25 IMU PCB Design
    [IMU_PCB.brd, IMU_PCB.sch]
2026-05-26 IMU Gerber files
    [IMU_PCB.GBL, IMU_PCB.GBO, IMU_PCB.GBP, IMU_PCB.GBS, IMU_PCB.GKO, IMU_PCB.GTL, IMU_PCB.GTO, IMU_PCB.GTP]
2026-05-27 Update IMU PCB and Upload Central Unit PCB
    [Adafruit BNO055 STEMMA QT.brd, Adafruit BNO055 STEMMA QT.sch, Adafruit BNO055.brd, Adafruit BNO055.sch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]
2026-05-29 PCB Design
    [Central_Unit_Case.stl, IMU_Breakout_Case.stl]
2026-07-03 Update and Central_Unit_V2
    [Central_Unit_Case.3mf, Central_Unit_Case.stl, Central_Unit_V2.brd, Central_Unit_V2.sch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]
2026-07-07 Sound interface
    [Central_Unit_Case.3mf, Central_Unit_Case_V2.3mf]
2026-07-16 Updates and visual feedback
    [Position_Measurement_20260423_131129.csv]
2026-08-28 3D Model
    [Position_Measurement_20260423_131129.csv]
